M4GNV5/DocGreenESA5000-Dashboard/(threads)

Thread 1 (2020-01-08):

Intensity of electric brake system

LaserPew, 2020-01-08:
Hey,

nice work on your dashboard and all the reverse engineering!

I don't know how relevant my question is to your project but I was wondering if you think that it would be possible to somehow adjust the electric brake intensity in firmware? My experience with the scooter so far is that the brake is really sudden as if the brake potentiometer is just binary (even though in your protocol documentation it says that the brake lever ranges from 2C to B5). Do you have the same experience or is it just me (I have the ESA 1919, but as far as I can tell the differences are just appearance).

Greetings

M4GNV5, 2020-01-08:
Hey,

there are two brakes: the electric brake and the disc brake. One big issue is that pulling the disc brake lever also brakes with 100% on the electric brake. A common mod is to unplug the sensor making the brake lever only operate the disc brake. In my custom dashboard the mechaical lever makes the [electric brake operate at 40%](https://github.com/M4GNV5/DocGreenESA5000-Dashboard/blob/master/DocGreenDisplay/DocGreenDisplay.ino#L531-L539)

The electric brake lever itself can be controled by pushing it ever so gently. Some people stated they feel like the electric brake is worse with a new scooter but is better dosable later. Could just be them getting used to controlling it though.

camp0s, 2021-02-22:
Sorry for opening this old issue, but I found a nice solution for the switch-brake:

the cable has two wires going to the dashboard red-blue. The Voltage (on the red) reads 4.4V, and when the brake lever is pushed (and the button activated) it reads "0v", maning a pull-down effect (and, maybe, a small voltage partitioning on the dash side in standby).

In that case (0V on the input) the Roller is breaking too hard. The objective it to keep the voltage UP and reduce the pull-down: it is simply accomplished **inserting a 1K resistor on the red wire**, thus influencing the pull-down circuit and allowing a 3.6V on the board's input, when the brake lever is pressed (10K is too much, the roller is not breaking at all, 100ohm is too low, voltage drops too much).

Now, when you brake with the lever, you can feel a gentle (but constant) E-brake slow-down - if more stopping power is required, lean on the back and dose the disk-brake: you can slide, while NOT locking the front wheel.

This mod is so simple, yet so effective! I hope it could help somebody.
(it's odd that the ESA is reading this input in a "analog way" (albeit inverted from the HALLs' logic), and they didn't cheap out with a DIG_in).

kaiomatico, 2021-02-22:
@camp0s  could you maybe provide a picture or a link to a tutorial? Thank you so much for the information, I was always hoping for such a mod

camp0s, 2021-02-22:
>
>
> @camp0s could you maybe provide a picture or a link to a tutorial? Thank you so much for the information, I was always hoping for such a mod

I.. resealed the dash with the leftover of the glue, but the mod is really simple:

_ find the wire from the switch of the brake, in my "Explorer 1919" it's red-blu
_ cut 1cm (no more!) of the red wire out, on the cable from the button to the connector
_ patch it with a 1kohm resistor (effectively replacing the piece of wire)

So, some ASCII art (like it's the late 80's again and 1200BPS modems were killing it):

DASH----wire---socket <-plugged-> plug----wire---brake_button
                                                                   ^-- remove the 1cm of cable there and solder the resistor

I might also add I tuned also the e-brake, the red left level.. but that took already 3-4 components to do it right, might take some screenshots soon :)

kaiomatico, 2021-02-27:
I made a photo of the installation on my ESA 5000
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
Thank you for the idea with the resistor - but I think it is still braking pretty hard, I guess I will try 2K and 3K resistors next :+1:

camp0s, 2021-02-28:
>
>
> I made a photo of the installation on my ESA 5000

Hi, really strange! Do you have a multimeter? can you measure the voltage on the connector in the photo, when connected, and tell us the normal voltage value and when you depress the button? On mine no action is 4.4V, and when I brake 3.6V.
To measure you stick the probes in the 2 small "windows" you see on the connector.

I used a 10K resistor (as a test) and the "braked" voltage was 4.3V and the brake was not activating at all (voltage too high).
With no resistor the voltage was 0V.

I tested in the garage, so a closed space, and the breaking power was reaaaaally soft.

Additional test: let the wheel freewheel holding the scooter up, the breake with the lever: with no resistor the wheel stops abruptly AND spins backward due to the intensity of the brake power.

With the resistor the wheel comes to a normal stop, with no backslash.

Closed 2020-01-10.

Thread 2 (2020-01-08):

Schematics, wiring diagram or better documentation

karlitos, 2020-01-08:
Hello Jakob, incredible work you did here 👍 I would love to build this display for me and maybe also to contribute and participate on the development. Would you be so kind and improve your documentation, so it includes detailed schematics or wiring diagram and also part listing (arduino board type, LCD module ... )

M4GNV5, 2020-01-08:
Hey,

The most important wiring is the bus wiring, which i took from [m365_dashboard](https://github.com/augisbud/m365_dashboard). Additionally i added latching buttons allowing to disable the bus connection and flash the arduino. and a big button power on/off, light and eco mode.

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

I guess i can create a schematic, but on the long run we plan to develop a PCB replacement which can be freely programmed.
you might want to join the ESA5k hacking group on telegram: https://t.me/ESA_5000_Hacking

karlitos, 2020-01-08:
Many thanks four your reply. I will first start with ordering some oled display and and aduino mini board. I found some 0.91 inch 128x32 OLED on Amazon with SSD1306 driver - looks similar to yours. Would be great to know how to connect it to the ESA board.

M4GNV5, 2020-04-14:
Hey,

i added a simple circuit to the readme created using https://www.circuit-diagram.org/.
I hope that explains how to connect the controller & inputs to the arduino.

Closed 2020-04-14.

Thread 3 (2020-06-17):

Which connector are they using for the dashboard to connect to the scooter?

CzokNorris, 2020-06-17:
Hi,
does anyone know what the name of the 4-pin connector is, that is used to connect the dashboard to the motor-controller in the steering column?
Its not a JST PH
But it is also 2.0mm and 4 pin.

M4GNV5, 2020-06-18:
Hey,

in the telegram group someone once said it should be a "JST PAP-04V-S".
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

Others said they bought [4Pin 2.0 PH 2.0mm Mini JST](https://www.ebay.de/itm/183101792371?ul_noapp=true). After removing the noses those should work too.

M4GNV5, 2020-06-20:
There also seem to be these: [HY-4A](https://lcsc.com/product-detail/Wire-To-Board-Wire-To-Wire-Connector_Boom-Precision-Elec-HY-4A_C146064.html) and [HY-4Y](https://lcsc.com/product-detail/Rectangular-Connectors-Housings_BOOMELE-Boom-Precision-Elec-HY-4Y_C146075.html)

carlosfd1, 2020-07-25:
It is called a "Grove" Connector and it is available at seeedstudio.com

M4GNV5, 2020-07-25:
Indeed, these seem to be the same ones: [male (scooter side)](https://www.seeedstudio.com/Grove-Universal-4-Pin-Buckled-20cm-Cable-5-PCs-pack.html) / [female (dashboard side)](https://www.seeedstudio.com/Grove-Universal-4-pin-connector.html)

Closed 2020-06-20.

Thread 4 (2020-06-29):

Controlling the dashboard buzzer

locomarco, 2020-06-29:
Do you think it is possible to make use of the dashboards buzzer?
I think the controller is doing that, when the immobilizer / lock mode is enabled.

M4GNV5, 2020-06-29:
Afaik the Buzzer is used for reporting error codes. So setting an error code could work.

Not sure what the vanilla dash does when locked. In the optimal case there might be a bit set by the controller when immobilizer is enabled and the scooter is moved causing the dashboard to buzz. But i neither have any protocol dumps nor a working vanilla dash to test that :frowning_face:
Maybe someone can do a bus dump of lock->push->unlock or something.

locomarco, 2020-06-29:
The original esa Dashboard beeps once/twice when activating/deactivating lock mode and beeps in short intervals when you try to move the scooter.
Unfortunately i don't have proper hardware to dump Bus messages myself.

I am just looking for a way to get some feedback when i for example set a new max speed.
Instead of the buzzer, i now just acitvate eco mode for a second, so the green led confirms the action.

Setting an error code would probably be a good idea, too.
I might try that soon.

Thank you 🙂👍

Closed 2020-06-29.

Thread 5 (2020-07-23):

DocGreenESA5000 Bluetooth Protocol

thisismck, 2020-07-23:
Do you have any work for original bluetooth protocol or do you plan to ad bluetooth for using with same morobot app?

M4GNV5, 2020-07-23:
The ESP32 has support for BLE, so in theory the protocol could be implemented. Currently i have no plans for Bluetooth functionality. Using WiFi & a Webinterface is cross plattform (Android / iOS / Desktop / ...) and does not require the user to install any app from a third party vendor.
However the hardware support is available so it could be added as a software update later. Feel free to implement the Bluetooth protocol and send a pull request :smiley: :stuck_out_tongue:

M4GNV5, 2020-09-09:
Hey,

26e979f9854659347671fbfe6ef56f634b9f8add implements the original M365 Protocol. I havn't tested it with many apps yet, but it definitely works with the M365 Plus app for iOS. Of course not all fields are supported but some are (range, speed, odometer, ...).
A screenshot of the app connected to my scooter:

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

Closed 2020-09-09.

Thread 6 (2021-02-22):

ESA 5000 Protocol: any other commands discovered?

camp0s, 2021-02-22:
Hi, just asking: are there any other commands available? Some in this repo are labeled "unsure": were any other commands/data_field discovered afterwards?

I'd be interested in the Temperature (if any) - and what about the current (A), I see that field in 2 commands, which one should be used?

Tnx!

M4GNV5, 2021-02-22:
Hey,

the documentation in [docgreen-protocol.md](https://github.com/M4GNV5/DocGreenESA5000-Dashboard/blob/master/docgreen-protocol.md) contains all the known fields i am aware of.

The temperature should be available, but currently i do not know where it is. [This repo](https://github.com/Bert-Tec/xbot_display/tree/master/serial) contains some bus sniffs with corresponding screenshots from the minirobot app. So you would have to search for some form of the temperature value `4.9` in the bus data. Same for electric current.

Some of the [sniffs in my repo](https://github.com/M4GNV5/DocGreenESA5000-Dashboard/tree/master/MegaSniffer/sniffs) are taken from there but in a different format and/or filtered.

camp0s, 2021-02-22:
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

Ah! I was wondering that too, I saw the Temperature in the screenshots - might give it a try ;)

camp0s, 2021-02-28:
It can be the value is simply coded as T(C)*10, dann 2 Bytes in total, somewhere in the packet. I'll look into the next week, using as reference also some dumps from a M365 where they found it!

Thread 7 (2021-03-25):

Latest PCB Design

zoon81, 2021-03-25:
Hi,

I just get this scooter and I love your dashboard project. Is the latest pcb design available?
Can you send a link to it?
Thank you and congrats!

M4GNV5, 2021-03-25:
Hey,

i haven't ordered and tested the latest design yet, it includes some improvements to WiFi/BLE connectivity and has 10 WS2812 mini LEDs for displaying information during drive, as people had problems with OLED brightness:

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

I still have some of the previous version laying around (soldered and unsoldered) though if you want one? This one:
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

Currently the PCB design isnt open source, people already started making money from the stuff in this repo by selling tuning chips on ebay, so im not sure if it ever will be open sourced :disappointed:

zoon81, 2021-03-28:
Thank you, and I totally understood you opinion about making the design open source.
I think I need only one pcb so I will put it on protoboard. Do you think that the display is not made for something like this?
I thought that the OLED is fine outside, but actually I never tried it. Maybe the cover just shade it too much.

M4GNV5, 2021-04-02:
OLEDs are fine outside. Its still readable, but it feels more like reading the station name on the radio in a car (i.e. 2-3 seconds distraction) rather than briefly looking at the displayed speed (i.e. 1-2 seconds distraction) if you know what i mean.

As github doesnt have direct messages feel free to send me a mail if you are interested in one of the PCBs.

Closed 2021-04-02.

Thread 8 (2021-03-29):

missing file "webinterface/bundle.hpp"

thisismck, 2021-03-29:
Hello M4GNV5, I cannot find bundle.hpp file. I want to try this codes for my scooter. And moreover, can you share arduino version bcs i dont want to use bluetooth and wifi and esp32 devkitc too big for dashboard place

M4GNV5, 2021-03-29:
Hey,

the `bundle.hpp` is generated using [generate-bundle.py](https://github.com/M4GNV5/DocGreenESA5000-Dashboard/blob/master/DocGreenDisplay/webinterface/generate-bundle.py). It basically combines the html, js and css files to a single file, gzips it and converts it to an `uint8_t` array.

The current upstream code uses some ESP32 specific libraries even for core functionality (e.g. the `Preferences` library), not just for WiFi and BLE. You can however try an older commit from this repo, namely [973d3b0ff8db8cf06b1be155ae9004223ea864b7](https://github.com/M4GNV5/DocGreenESA5000-Dashboard/tree/973d3b0ff8db8cf06b1be155ae9004223ea864b7) should work on an Arduino board and allow most functionality like tuning, displaying stats etc.

With git CLI: `git checkout 973d3b0ff8db8cf06b1be155ae9004223ea864b7`
Otherweise just download the [code of the commit from this link](https://github.com/M4GNV5/DocGreenESA5000-Dashboard/archive/973d3b0ff8db8cf06b1be155ae9004223ea864b7.zip)

Closed 2021-04-02.

Thread 10 (2023-07-07):

Name of the connectors

Metaln00b, 2023-07-07:
Hello and thank you for sharing your work.

Can you tell us what is the exact name of the used connectors at the TinyTuning(Button)?

Metaln00b, 2023-07-08:
There is the answer:

https://github.com/ands/EsaBusModule/issues/5

Thank you

Closed 2023-07-08.
