M4GNV5/DocGreenESA5000-Dashboard/TinyTuning/protocol.h

#pragma once

#include <stdint.h>
#include <SoftwareSerial.h>

// send a packet multiple times with small delays to make sure it arrived
// even when one of them collided with another packet on the bus
#define SEND_REPEAT(func) do { \
		delay(7); \
		func; \
		delay(13); \
		func; \
		delay(5); \
		func; \
	} while(0)

// we could use protocol.h from DocGreenDisplay, but it's docgreen_status_t
// structure alone needs 12% of the ATtiny's RAM (31 of 256 byte)
// thus below are parts rewritten without using buffers or large structs

#ifndef UART_TX_PIN
#define UART_TX_PIN 3
#endif
#ifndef UART_RX_PIN
#define UART_RX_PIN 4
#endif
SoftwareSerial ScooterSerial(UART_RX_PIN, UART_TX_PIN);

typedef struct
{
	uint8_t throttle;
	uint8_t brake;

	uint16_t speed; // meters per hour

	uint8_t ecoMode : 1;
	uint8_t lights : 1;
	uint8_t buttonPress : 1;

	// used and set in TinyTuning.ino, just defined here to save RAM
	uint8_t isTuned : 1;
	uint8_t isLocked : 1;
	uint8_t inDrive : 1;
} docgreen_tiny_status_t;

inline void sendUint16LE(uint16_t val)
{
	ScooterSerial.write((val & 0xff));
	ScooterSerial.write((val >> 8));
}

void setMaxSpeed(uint8_t speed)
{
	const uint8_t PROGMEM data[] = {
		0x55, 0xAA, 0x04, 0x22, 0x01, 0xF2,
	};

	uint16_t rpm = ((uint16_t)speed * 252) / 10;

	uint16_t checksum = 0x119; // sum of 0x04, 0x22, 0x01, 0xF2
	checksum += (rpm & 0xff);
	checksum += (rpm >> 8);
	checksum ^= 0xFFFF;

	ScooterSerial.stopListening();
	ScooterSerial.write(data, sizeof(data) / sizeof(uint8_t));
	sendUint16LE(rpm);
	sendUint16LE(checksum);
	//ScooterSerial.listen();
}

static void setOption(uint8_t id, bool enabled)
{
	const uint8_t PROGMEM data[] = {
		0x55, 0xAA, 0x04, 0x22, 0x01,
	};

	uint16_t checksum = 0x27; // sum of 0x04, 0x22, 0x01
	checksum += id;
	if(enabled)
		checksum += 1;
	checksum ^= 0xFFFF;

	ScooterSerial.stopListening();
	ScooterSerial.write(data, sizeof(data) / sizeof(uint8_t));
	ScooterSerial.write(id);
	ScooterSerial.write(enabled ? (uint8_t)0x01 : (uint8_t)0x00);
	ScooterSerial.write((uint8_t)0x00);
	sendUint16LE(checksum);
	//ScooterSerial.listen();
}
inline void setEcoMode(bool enabled)
{
	setOption(0x7C, enabled);
}
inline void setLock(bool enabled)
{
	setOption(0x7D, enabled);
}
inline void setLight(bool enabled)
{
	setOption(0xF0, enabled);
}

uint8_t readWithDefault()
{
	// give the scooter some time
	if(!ScooterSerial.available())
		delay(1);

	if(ScooterSerial.available())
		return ScooterSerial.read();
	else
		return 0x00;
}
bool receivePacket(docgreen_tiny_status_t& status)
{
	if(readWithDefault() != 0x55)
		return false;
	if(readWithDefault() != 0xAA)
		return false;

	uint8_t len = readWithDefault();
	uint8_t addr = readWithDefault();
	if(len == 0 || (addr != 0x25 && addr != 0x28))
		return false;

	uint16_t sum = len;
	sum += addr;
	len += 2;

	for(int i = 2; i < len; i++)
	{
		uint8_t val = readWithDefault();
		sum += val;

		if(addr == 0x25) // input info packet
		{
			if(i == 2 && val != 0x60)
				return false;
			else if(i == 5)
				status.throttle = val;
			else if(i == 6)
				status.brake = val;
		}
		else if(addr == 0x28)
		{
			switch(i)
			{
				case 4:
					status.ecoMode = val == 0x02;
					break;
				case 6:
					status.lights = val == 0x01;
					break;
				case 8:
					status.speed = (uint16_t)val << 8;
					break;
				case 9:
					status.speed |= val;
					break;
				case 10:
					status.buttonPress = val == 0x01;
					break;
			}
		}
	}

	uint16_t actualChecksum = (uint16_t)readWithDefault() | ((uint16_t)readWithDefault() << 8);
	sum ^= 0xFFFF;
	if(actualChecksum != sum)
		return false;

	return true;
}
