M4GNV5/DocGreenESA5000-Dashboard/DocGreenDisplay/update.hpp

#include <WiFi.h>
#include <HTTPUpdate.h>
#include <time.h>
#include <thread>

#include "config.h"
#include "state.hpp"

// see: https://letsencrypt.org/certificates/
// direct link: https://letsencrypt.org/certs/lets-encrypt-x3-cross-signed.pem.txt
const char *letsEncryptX3RootCa = \
"-----BEGIN CERTIFICATE-----\n" \
"MIIEkjCCA3qgAwIBAgIQCgFBQgAAAVOFc2oLheynCDANBgkqhkiG9w0BAQsFADA/\n" \
"MSQwIgYDVQQKExtEaWdpdGFsIFNpZ25hdHVyZSBUcnVzdCBDby4xFzAVBgNVBAMT\n" \
"DkRTVCBSb290IENBIFgzMB4XDTE2MDMxNzE2NDA0NloXDTIxMDMxNzE2NDA0Nlow\n" \
"SjELMAkGA1UEBhMCVVMxFjAUBgNVBAoTDUxldCdzIEVuY3J5cHQxIzAhBgNVBAMT\n" \
"GkxldCdzIEVuY3J5cHQgQXV0aG9yaXR5IFgzMIIBIjANBgkqhkiG9w0BAQEFAAOC\n" \
"AQ8AMIIBCgKCAQEAnNMM8FrlLke3cl03g7NoYzDq1zUmGSXhvb418XCSL7e4S0EF\n" \
"q6meNQhY7LEqxGiHC6PjdeTm86dicbp5gWAf15Gan/PQeGdxyGkOlZHP/uaZ6WA8\n" \
"SMx+yk13EiSdRxta67nsHjcAHJyse6cF6s5K671B5TaYucv9bTyWaN8jKkKQDIZ0\n" \
"Z8h/pZq4UmEUEz9l6YKHy9v6Dlb2honzhT+Xhq+w3Brvaw2VFn3EK6BlspkENnWA\n" \
"a6xK8xuQSXgvopZPKiAlKQTGdMDQMc2PMTiVFrqoM7hD8bEfwzB/onkxEz0tNvjj\n" \
"/PIzark5McWvxI0NHWQWM6r6hCm21AvA2H3DkwIDAQABo4IBfTCCAXkwEgYDVR0T\n" \
"AQH/BAgwBgEB/wIBADAOBgNVHQ8BAf8EBAMCAYYwfwYIKwYBBQUHAQEEczBxMDIG\n" \
"CCsGAQUFBzABhiZodHRwOi8vaXNyZy50cnVzdGlkLm9jc3AuaWRlbnRydXN0LmNv\n" \
"bTA7BggrBgEFBQcwAoYvaHR0cDovL2FwcHMuaWRlbnRydXN0LmNvbS9yb290cy9k\n" \
"c3Ryb290Y2F4My5wN2MwHwYDVR0jBBgwFoAUxKexpHsscfrb4UuQdf/EFWCFiRAw\n" \
"VAYDVR0gBE0wSzAIBgZngQwBAgEwPwYLKwYBBAGC3xMBAQEwMDAuBggrBgEFBQcC\n" \
"ARYiaHR0cDovL2Nwcy5yb290LXgxLmxldHNlbmNyeXB0Lm9yZzA8BgNVHR8ENTAz\n" \
"MDGgL6AthitodHRwOi8vY3JsLmlkZW50cnVzdC5jb20vRFNUUk9PVENBWDNDUkwu\n" \
"Y3JsMB0GA1UdDgQWBBSoSmpjBH3duubRObemRWXv86jsoTANBgkqhkiG9w0BAQsF\n" \
"AAOCAQEA3TPXEfNjWDjdGBX7CVW+dla5cEilaUcne8IkCJLxWh9KEik3JHRRHGJo\n" \
"uM2VcGfl96S8TihRzZvoroed6ti6WqEBmtzw3Wodatg+VyOeph4EYpr/1wXKtx8/\n" \
"wApIvJSwtmVi4MFU5aMqrSDE6ea73Mj2tcMyo5jMd6jmeWUHK8so/joWUoHOUgwu\n" \
"X4Po1QYz+3dszkDqMp4fklxBwXRsW10KXzPMTZ+sOPAveyxindmjkW8lGy+QsRlG\n" \
"PfZ+G6Z6h7mjem0Y+iWlkYcV4PIWL1iwBi8saCbGS5jN2p8M+X+Q7UNKEkROb3N6\n" \
"KOqkqm57TH2H3eDJAkSnh6/DNFu0Qg==\n" \
"-----END CERTIFICATE-----\n";

String firmwareUpdateUrl;
String firmwareUpdateStatus = "uninitialized";

void checkForFirmwareUpdates()
{
	// wait for time from NTP server
	time_t now = time(nullptr);
	int ntpWait = 0;
	while(now < 8 * 3600 * 2)
	{
		ntpWait++;
		if(ntpWait > 20)
		{
			firmwareUpdateStatus = "NTP timeout";
			return;
		}

		delay(500);
		now = time(nullptr);
	}

	WiFiClientSecure client;
	client.setCACert(letsEncryptX3RootCa);
	client.setTimeout(10);

	httpUpdate.rebootOnUpdate(false);
	t_httpUpdate_return ret = httpUpdate.update(client, firmwareUpdateUrl);

	if(ret == HTTP_UPDATE_OK)
		firmwareUpdateStatus = "success, please restart";
	else if(ret == HTTP_UPDATE_NO_UPDATES)
		firmwareUpdateStatus = "no updates";
	else
		firmwareUpdateStatus = "error: " + httpUpdate.getLastErrorString();
}

void setupFirmwareUpdate()
{
	firmwareUpdateUrl = preferences.getString(PREFERENCE_UPDATE_URL, DEFAULT_UPDATE_URL);

	if(!wifiStaEnabled)
	{
		firmwareUpdateStatus = "no internet";
		return;
	}

	firmwareUpdateStatus = "not started";
}
