M4GNV5/DocGreenESA5000-Dashboard/(commit log)

2019-12-24 initial version containing a protocol sniffer, some sniffing files, a selfmade documentation of the protocol and a replacement for the head unit using an arduino and a small OLED
    [DocGreenDisplay.ino, MegaSniffer.ino, config.h]
2019-12-24 small visual changes of shutdown and error visualization
    [DocGreenDisplay.ino]
2019-12-27 add a lock screen shown when booting which prevents strangers from driving
    [DocGreenDisplay.ino]
2019-12-27 some usability improvements and lock fix
    [DocGreenDisplay.ino]
2020-01-06 rework the menu controls and add a tuning menu allowing to set the max speed (max allowed by the motor controller is 30km/h)
    [DocGreenDisplay.ino]
2020-02-14 implement the missing packets in protocol.h
    [protocol.h]
2020-02-20 add two new config options for setting the default max speed on boot and for reenabling light after an error
    [DocGreenDisplay.ino, config.h]
2020-02-20 rework the menu adding a config submenu and a stats page showing voltage, current, operation time and odometer
    [DocGreenDisplay.ino, protocol.h]
2020-02-20 fix some compiler errors and logic bugs found when testing the latest commits
    [DocGreenDisplay.ino, protocol.h]
2020-02-21 use the lock functionality built into the ECU for lock mode (it actively powers the motor when pushing it and prevents power off)
    [DocGreenDisplay.ino]
2020-02-21 fix occasional error 10s when locked and increase the blink frequency
    [DocGreenDisplay.ino]
2020-04-12 fix wrong protocol documentation (requesting & retrieving detailed info now actually works :))
    [protocol.h]
2020-04-13 refactor the stats requesting code into the sendInputInformation function as the stats request packets also contain info about throttle/brake state
2020-04-14 add wiring circuit to the readme (fixes #2)
2020-04-14 fix typo in circuit
2020-06-11 dashboard: code cleanup and small fixes
    [DocGreenDisplay.ino]
2020-06-11 allow to brake more than 40% on the front wheel when holding both brakes
2020-06-13 add custom pcb info & images to the readme
2020-07-12 add support for the ESP32 to the dashboard code
    works on rev1.1 of the dashboard PCB, but the level shifter does not shift analog signals, thus the gas & brake sensors are broken :(
    [DocGreenDisplay.ino, oled-ui.hpp, protocol.h]
2020-07-12 add new images and the newest PCB schematic to the readme
2020-07-14 use a set of global state variables (i know its ugly, but that is how most arduino stuff works).
    they are declared in state.hpp and defined in the file they belong to
2020-07-16 use the esp32 Preferences library for user settings instead of constants from config.h
2020-07-17 fix bugs in webserver.hpp and actually include it in DocGreenDisplay.ino
    [DocGreenDisplay.ino, webserver.hpp]
2020-07-17 implement proper wifi handling, allowing station mode, using a wifi ap ssid based on the device mac and a random password
2020-07-29 make the web update actually work (currently blocking though)
2020-08-03 flip the SoC and acceleration gauges and prevent the esp32 libs to save wifi config to the flash
    [wifi.hpp]
2020-08-05 remove the pcb schematic SVGs (they are all broken anyways)
2020-08-12 remove the parsing of the 08 25 07 ... packet, byte 4 does not really seem a temperature
2020-08-12 fix the default value of lock-on-boot in the webinterface
    [webserver.hpp]
2020-08-15 fix occasionaly getting stuck in the packet read loop
    [protocol.h]
2020-08-15 fix some bugs in the previous commits
    [protocol.h]
2020-08-18 remove the auto update option, but add a button for updating the software instead
2020-09-04 DocGreenDisplay: correctly drive the LED output pin according to the light status received from the ESC
    [DocGreenDisplay.ino, config.h]
2020-09-09 small config bugfix for the last commit (fixing inability to change bluetooth setting to on)
    [webserver.hpp]
2020-09-12 fix Android M365 Bluetooth app issues
    [bluetooth.hpp]
2020-09-13 set the pin to '000000' (ascii zeros)
2020-09-13 dashboard ble: allow reading the TX characteristic and writing the RX characteristic without response (fixes compatability with the DarknessBot iOS App)
    [bluetooth.hpp]
2020-09-16 tinytuning: track an in drive state, similar to the inDrive in the dashboard
2020-10-04 dashboard: fix light, ecomode and lock control via bluetooth
    [bluetooth.hpp]
2020-10-09 dashboard: recode the reenable light after error functionality to not require receiving a packet with an error code
    [DocGreenDisplay.ino]
2020-10-14 TinyTuning: smash two bugs in protocol.h
    [protocol.h]
2020-10-18 fix speeds set via the OLED UI not saved permanently
    [oled-ui.hpp]
2020-10-23 dashboard: fix reenableLight behaviour preventing all other modules to turn off the light
    [DocGreenDisplay.ino, bluetooth.hpp, oled-ui.hpp, reenable-light.hpp, state.hpp, webserver.hpp]
2020-10-23 do not auto reboot after an update
    [update.hpp]
2020-10-25 Add a new TinyTuningButton, which is similar to TinyTuning, but uses the regular scooter button for user interaction
2020-10-25 TinyTuningButton: make sure the Eco mode is on long enough to be noticable regardless of the mode switching lag
2020-11-13 TinyTuningButton: rewrite button press detection using polling instead of interrupts
2020-11-13 TinyTuningButton: fix code spacing
    [TinyTuningButton.ino]
2020-12-08 TinyTuningButton: simplify code and use interrupts for button click detection
